ut-robotics/picr21-team-bts/README.md

# picr21-team-bts
###### 
## Repo Structure Overview:
- > Mechanics [Fusion 360](https://a360.co/3qvp5Xd)
- > Electronics [ELE Dev](https://github.com/ut-robotics/picr21-team-bts/tree/main/Electronics)
- > Final Programming files: [BTS Dev](https://github.com/ut-robotics/picr21-team-bts/tree/main/BTS%20dev)
- > Readme TBA

### picr21-team-bts
To this day nobody knows what B T S<sup>TM</sup> is or what means... 
<sub>but maybe it means: break the solution? who knows!</sub>
##### All we do is: Let's maek tha robit do The Thing!<sup>TM</sup>
