ut-robotics/picr21-team-bts/(threads)

Thread 1 (2021-09-19):

[Mechanics] - Test thrower sketch is not fully defined

Akustav, 2021-09-19:
The sketch is missing some constraints and dimensions, that is why it is blue.
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
If I were to move a vertex, unexpected things can happen, making it extremely difficult to modify this sketch further. Case and point: When moving one corner vertex this happened.
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

mbz4, 2021-09-19:
ok, will add some dimension pointers to the sketch to reference about origin

mbz4, 2021-09-23:
made a hot mess of things but it works now: sketch fully defined (i hope, tested a lot)

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

mbz4, 2021-09-23:
nevermind, just saw the blue peg hole xD
ok fixed!

Akustav, 2021-09-25:
Seems to be OK now with the components, yes.

Closed 2021-09-25.

Thread 2 (2021-09-19):

[Mechanics] - Hole sizes should be correct to their purpose

Akustav, 2021-09-19:
Hole sizes in components are wrong. Holes that need to be threaded should have proper predrill diameters. They can be seen in this PDF

https://www.alliedmachine.com/AlliedMachine/media/AlliedMasterPageImages/Documents/Predrill-Diameter-Chart.pdf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

If you want to have these holes threaded they are too large, if you want to pass a bolt through them, they are to small:
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

Similar issues here:
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

I suggest checking over all the holes in the components.

mbz4, 2021-09-19:
The hole sizes are actually correct.
1) the vertical holes are based exactly as the holes in the adapter plates of the previous teams design and as such i have no say on how they are setup
2) the horizontal holes that i added are not as constrained but the idea of printing the item is that you dont need to pretap in printing, you can tap the threads in later. I will reduce the 2.9mm diameter to 2.5mm
3) the reduced diameter will allow for more 'meat' in the screws to be inserted after the printing is complete, in other words, i will manually add the threads by inserting the screws
4) if you prefer a more reliable attachment method, i could also use a nut, washer, bolt inlay technique or a jig saw resetter type interlock but this would increase the complexity of the preliminary design stage unnecessarily imho

Akustav, 2021-09-19:
1. For the vertical holes, the size is an issue. Tapped holes should be 2.5mm in diameter. Their location itself is OK if the frame has them there (missing from assembly).
2. I am not sure where you got the ideal hole sizes but usually, 3D-printed holes come out a little smaller than expected, requiring re-drilling for any precision at all. If the ramp holes are 2.9mm then the sidewall holes can not be 2.9 mm because a bolt needs to go through them, requiring a larger hole.
3. For component longevity it is suggested to cut proper threads. Threads "cut" using a screw are of lower quality since cutting is not clean and remains stay in the hole. It is OK if you fasten it only once ever but for a re-assemblable component, it should be properly cut. If you need more meat it can be adjusted in the slicer.
4. Bolts and threads are sufficient, it is just very unclear where holes need to be threaded and where not. This ambiguity is not good.

mbz4, 2021-09-23:
>> side adapter with motor mount hole sizes fixed: 3.1mm in passthru adapters, 2.5mm in chassis mounts
>> side adapter with no motor mount hole sizes fixed: same as above
>> ramp: tapped hole dim now corrected to 2.5mm

Akustav, 2021-09-25:
Seems fine now, yeah. Closing issue.

Closed 2021-09-25.

Thread 3 (2021-09-19):

[Mechanics] - Thrower arch is weird

Akustav, 2021-09-19:
I am not sure why the throwers ramp is designed in such a way:
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
The radius is not aligned with the centre of the motor. The ball does not seem to make a lot of contact with the ramp at the beginning of the throw.

Additionally, the ball makes contactwith the motor alot sooner than with the ramp. This can force the robot to jump, reducing accuracy. This happens when the ball is pulled from position one to position 2:
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

mbz4, 2021-09-19:
Again, the measurements for motor position are only referenced from last years robot model.
In the given timeframe it was not possible to finetune the design to this degree.
Additionally, the ramp geometry is comprised out of two concentric circles, the motor axis is indeed not in the central axis mount as it should be. The draft angle between both ramp curves serves as the simplest self-centering geometry I could quickly implement.
One solution may be that I move the motor mount up a few mm such that the 'jump' would not occur, assuming the carpet is as depicted.

Akustav, 2021-09-19:
I think you should align the centre of the motor with the ramps curvature centre. Since you have full control of where the motor is located then you can also decide how far the ramp extends, helping avoid the issue where the robot is lifted during ball acquisition.

Using pro-paint skills I have illustrated some changed that would be nice:
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

Akustav, 2021-09-27:
Hey! Still a little bug here:
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

Akustav, 2021-10-03:
Closing due to new design

Closed 2021-10-03.

Thread 4 (2021-09-19):

[Mechanics] - 3D print orientation

Akustav, 2021-09-19:
In what orientation do you plan to 3D-print the central part? You need to take into consideration that one can not print on air. I am not sure if you considered it. It is not immediately clear to me.

mbz4, 2021-09-19:
1) https://www.explainthatstuff.com/how-3d-printers-work.html ...this is the thrower design review request, not print setup... for that i would first need slicer profile settings and slicing to take place...
2) the part is already designed in print orientation - the bottom most face allows for sufficient adhesive area such that the layers atop will not detach the piece off a properly calibrated buildplate
3) the part has no angles exceeding 60degrees in layering (see prusa references on design recommendations)

Akustav, 2021-09-19:
Ok. I guess this works. Just an additional thing that layer orientation in 3D printing matters, similar to how it is on wood. For this component the presented orientation most likely will work, just was not clear from the onset.

Closed 2021-09-19.

Thread 5 (2021-09-19):

[Mechanics] - Thrower missing chassis assembly

Akustav, 2021-09-19:
The thrower assembly does not include chassis components, making it hard to judge the distances between the motor and the ground of the machine. Additionally it is hard to judge if it is attachable to the existing test-chassis.

mbz4, 2021-09-19:
Instructions did not mention the assembly needs to include chassis parts even though I referenced all dimensions from model and real parts.
These seem like superficial issues but I will add them to the model.
The bottom most face of the ramp component is exactly on level with last years ramp bottom.

Akustav, 2021-09-19:
Having the chassis in the model helps to see that. Since these components do not work in a vacuum but need to operate in an assembly it is important to see that everything fits together and operates as expected.

Closed 2021-09-27.

Thread 6 (2021-09-19):

[Mechanics] - Intererence between components

Akustav, 2021-09-19:
There are components that sit inside one another. They can be seen below:
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

mbz4, 2021-09-19:
not sure i understand, but perhaps the joinery was not up to the task
i can offset the joints in the assembly if thats the issue

the adapter rings are there because i noticed and measured an offset of about 2mm either side
Im not sure what else would cause the interference but this is what you can expect in rushed designs.

Akustav, 2021-09-19:
The spacers seem to be placed wrong, they are 2 mm wide for a 1.7mm gap.

Akustav, 2021-10-03:
Clsoing to review new iteration

Closed 2021-10-03.

Thread 10 (2021-10-03):

[Mechanics] - add chamfers to simplify assembly

Akustav, 2021-10-03:
Adding chamfers to tabs should simplify assembly and it should not affect manufacturing times.

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

mbz4, 2021-10-03:
Will add chamfers on key insert edges.

mbz4, 2021-10-03:
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
Done on all contacting insert edges.

Thread 11 (2021-10-03):

[Mechanics] - add chassis components to assembly

Akustav, 2021-10-03:
Currently the assembly has only the thrower. Add the important chassis components there to validate that there is no interference between components and that the attached throwers parameters match with clearance and other factors.

mbz4, 2021-10-03:
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

mbz4, 2021-10-03:
Chassis added to assembly. Attached thrower assembly's parameters match with clearances and other factors.

mbz4, 2021-10-03:
See to assembly file: "BTS TEST ROBOT ASSY.v3"

mbz4, 2021-10-03:
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

Thread 7 (2021-10-03):

[Mechanics] - use chamfer instead of bevel

Akustav, 2021-10-03:
I suggest using chamfer here so certain parts are not printed on thin air:

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

This change should not break anything on first check.

mbz4, 2021-10-03:
Agreed, fillet angle exceeding 60degrees. Disregardable if using layer height under 0.15mm but will apply chamfer regardless.

mbz4, 2021-10-03:
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
Done.

Thread 8 (2021-10-03):

[Mechanics] - sidewall consist of 2 bodies

Akustav, 2021-10-03:
The sidewall consists of 2 bodies. I think you want to unify them into one, since it is one component. To do that you can use the "combine" modifier.

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

mbz4, 2021-10-03:
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
Fixed: sidewall now a single body. Moved extrude over by one slot then used Join method in adapter block extrude.

Thread 12 (2021-10-08):

[Mechanics] - deepen holes

Akustav, 2021-10-08:
I suggest making these holes deeper. Threading tools have a tip that can not be used for cutting and a deeper hole makes for better threads and for more space for shavings to go.

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

mbz4, 2021-10-08:
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
Done. Reslicing now.

Closed 2021-10-29.

Thread 17 (2021-10-25):

Code functionality hard to extend

Akustav, 2021-10-25:
https://github.com/ut-robotics/picr21-team-bts/blob/150fad70ade07c8de07883c7dcfbdee1cfe69f68/Mainboard%20Communication%20Tasks/basic.py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

The current program is written as a monolith and not expandable. All tasks during the course build on top of the previous tasks. I would therefore suggest a state machine and the first state can be for simple motion forward.

Farnaz03, 2021-11-08:
Working on it: https://github.com/ut-robotics/picr21-team-bts/tree/main/Programming

Akustav, 2021-11-12:
Added another issue explaining basic state-machine stuff. Closing this one

Closed 2021-11-12.

Thread 19 (2021-10-25):

Reduce duplicate code

Akustav, 2021-10-25:
https://github.com/ut-robotics/picr21-team-bts/blob/150fad70ade07c8de07883c7dcfbdee1cfe69f68/Mainboard%20Communication%20Tasks/main2_1.py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

Currently motor speed calculations, sending and camera logic is duplicated in multiple files. I would suggest moving common logic to separate files.

Farnaz03, 2021-11-08:
Working on separating it: https://github.com/ut-robotics/picr21-team-bts/tree/main/Programming

Closed 2021-11-08.

Thread 21 (2021-10-25):

Abstraction layer for motion missing

Akustav, 2021-10-25:
https://github.com/ut-robotics/picr21-team-bts/blob/150fad70ade07c8de07883c7dcfbdee1cfe69f68/Mainboard%20Communication%20Tasks/main2_1.py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

The current  motion code sends raw motor speeds to the mainboard. This is a non-intuitive way of moving omnidirectionally and in all likelyhood in need of an abstraction layer.

Farnaz03, 2021-11-08:
Kindly review: https://github.com/ut-robotics/picr21-team-bts/blob/main/Programming/maneuver_inator.py
Let us know if this works better. We took inspiration from LoganPaul (2020), Thomas The Dunk Engine (2020), Team Kobe (2021), Team Jordan (2021) and also your suggested side, forward, rotate movement structure - but we have so far only implemented a single move command.

Akustav, 2021-11-12:
Seems more reasonable now.

Closed 2021-11-12.

Thread 22 (2021-10-29):

[Mechanics] - roller number does not divide by fastening holes

Akustav, 2021-10-29:
Currently you have 25 rollers for 4 fastening holes. I would suggest either going with 40 rollers or 5 fastening holes.

mbz4, 2021-10-29:
Since we are limited to 20 rollers per wheel, it is not possible to go with the 40 rollers option.
5 fastening holes is a better solution. Guess I will make this solution work then.

mbz4, 2021-10-30:
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
Done.

Akustav, 2021-10-31:
OK

Closed 2021-10-31.

Thread 23 (2021-10-29):

[Mechanics] - motor fastener impossible to lathe

Akustav, 2021-10-29:
All torque related to robot movement will be transferred through the fastening piece. The load is also dynamic since accelerations are quire strong on these pieces. I suggest making it out of metal (aluminum or similar) using the lathe.

mbz4, 2021-10-29:
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
Hey, the adapter piece is made of aluminum: I figured I could use the lathe to get the rough diameter then the mill to mill out the retention hole. Another solution is to simply use the lathe and make a monolith cylinder, with a side where the screw goes through to pin on the shaft of the motor, holes for the wheel screws and of course the hole for the motor shaft - not sure how to make the flat edge in that case but it should work even without it.
In the design, I actually use a flat face on the printed base and lid blocks to help translate the torques but these parts are not meant to work alone in this fashion. I wanted to distribute these loads as much as possible.

I guess I should remake the design to whatever we can fabricate then.
There should be something I can do to simplify this design.

mbz4, 2021-10-30:
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
Perhaps an adapter like this would be better then: 2 separate radii to lathe out, a centre bore for the motor shaft. Then on the mill: 5 vertical screw mount holes  (2.9mm dia), 1 cross-cut horizontal screw hole.

I went with a through cut on the horizontal screw mount in case we want to use part of a threadlocked screw insert as the flat face against which the motor shaft rests and/or as a second retention screw.
In any case it is an optional part that is simply a nice through-mill to fabricate.

mbz4, 2021-10-30:
I would sand the edges to get the chamfers except for the inner most one which can be achieved if I simply avoid lathing that part to get a nicer transition to the central shaft holder.

mbz4, 2021-10-30:
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

Akustav, 2021-10-31:
I would use the second variant, yes. One thing I think we can change is to reduce the OD of the holder. This lets us save material and reduce the time of making this piece. The 4/5/however many fastening holes can be pretty close to the edges of the shaft holder and the OD.

One suggestion I can make is that the holes holding the motor shaft should be offset from the wheel fastening holes, like so:

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

This reduces possible assembly complications in the case some the bolts used are too long

mbz4, 2021-10-31:
Seems the thread here is out of date: I addressed this issue soon after posting the above screenshots. It's angled correctly now, but to achieve this, I had to reposition the fastener holes in order to keep the horizontal retentors aligned with the flat of the motor shaft.

mbz4, 2021-11-02:
Why is this issue still open?

Akustav, 2021-11-02:
Current design is better.

Closed 2021-11-02.

Thread 24 (2021-10-29):

[Mechanics] - donät leave play on the motor shaft hole

Akustav, 2021-10-29:
Currently the radius of the motor shaft hole is 3.1 mm. I suggest not leaving any play there.

mbz4, 2021-10-29:
So you suggest the roller shafts should be immobilized and inside a contour that maximizes friction.

mbz4, 2021-10-30:
Done: motor shaft hole = 3mm

Akustav, 2021-10-31:
In what model was this changed?

mbz4, 2021-10-31:
Both the twin-bore and regular.

mbz4, 2021-11-02:
Why is this issue open still?

Akustav, 2021-11-02:
Is OK now

Closed 2021-11-02.

Thread 25 (2021-10-29):

[Mechanics] - Change way how rollers are retained

Akustav, 2021-10-29:
Currently the tolerances for the rollers might be to little and they might not spin freely. To avoid this you can increase side clearance on either side to around 0.2-0.3 mm and extrude a cone like area around the roller shaft that supports the roller from movement. The tolerances on the cone can be right at 4.0mm.

Visual illustrations (not to scale):

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

An example wheel picture

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

mbz4, 2021-10-29:
I can approach this issue by making the hole model for the rollers separate of the hole model for the shafts. I'll therefore define a new sketch on the side of one roller wall and then make a cut and then use the circular pattern on this cut for all the rollers.

mbz4, 2021-10-30:
Somehow missed the point about the extruded conical shape to keep the roller tight at 4.0mm while permitting play at 0.2-0.3mm in all new designs...
I think I can add it still but this will involve several hundred modifications.
Do you need me to fully assemble the wheels for each iteration or can I leave the non-final versions more disassembled (only 1 or 2 rollers fitted for illustration).
Can fully assemble once we've gone thru feedback I guess.

mbz4, 2021-10-30:
Okay, fixed for standard config. Tackling twin-bore config next.

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

mbz4, 2021-10-30:
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
It's just a conical extrusion, achieved thru a standard solid join extrude, then chamfered to a nice tip.

mbz4, 2021-10-30:
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
Done for both wheel configs.
Reviewed all issues again and I think it's all addressed adequately now.
Kindly accept the final design for submission per pending task requirements.

Akustav, 2021-10-31:
Seems nice now.

Closed 2021-10-31.

Thread 26 (2021-10-29):

[Mechanics] - plans on covering the wheel

Akustav, 2021-10-29:
A question regarding how the wheel will fit into the whole assembly. Do you plan to cover the wheel?

This is important because currently rollers and bolts holding the wheel together can damage parts of the field (baskets) and opponents when they are grazed by the spinning wheel.

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

mbz4, 2021-10-29:
I thought we could inset the entire wheel-motor assembly inside the robot chassis such that this would not be an issue. With regard to this, I would prefer to just have the chassis encircle the entire assembly. If this is a new addition to the competition guidelines, I can make the screws sink into the wheel itself with counterbores and make the blocks thicker as well.

Akustav, 2021-10-31:
Having wheels in the chassis is reasonable. Just pointed out this to be careful with.

Closed 2021-10-31.

Thread 27 (2021-10-30):

[Mechanics] New repatterned roller design based off feedback.

mbz4, 2021-10-30:
Didn't have a chance yet to repattern the twin bore config but this is a learning process so have patience.

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

Here's the newly repatterned wheel: diam is now 7cm, 20 rollers, 4 fasteners, lathable adapter, wheels intended for use inside the chassis. If this not acceptable, can extend base and lid blocks to encompass roller diam and have screw points in-bore.

mbz4, 2021-10-30:
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
I'll start work on a rough outline of the motor mount next.
Having an easily modifiable motor mount design series would help me with quick sanity checks in the wheel design department.

Also, I used the feature circ. pattern on a 8mm cut for all the roller shafts such that the resulting contour is tight fitting with no play. The roller bearing play is now 0.275mm either side of the roller. This is within the margins you specified. Even if 3dprinted, the shafts might be too constricted and the resulting assembly could deform due to printer tolerance mismatches.

mbz4, 2021-10-30:
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
Adjusted fastener holes to allow the horizontal fasteners enough space.
Aligned horizontal fastener with flat part of motor shaft.
Working on counterbores next.

mbz4, 2021-10-30:
Wanted to wrap up this assy before moving on to the twin-bore or the motor mount design daft.
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
Counterbores added: don't mind having them on either side of the wheel block because I thickened the wheel so that it now encompasses the entire roller diameter. This way there is 4mm of material from the bore to bore fastener hole to keep the parts clamped together. This shouldn't be an issue.
Will consider now this wheel assy done.

mbz4, 2021-10-30:
The counterbore mismatch was irritating so  I decided to have 2 distinct blocks instead such that the lid simply does not feature the counterbore for the fasteners.

mbz4, 2021-10-30:
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
Here's the twin-bore concept with 20 roller wheel assy, 10 rollers per base. Roller shafts fit in the contoured shapes nicely. The fasteners are a divisible of 20, but could have used 4 instead of 5 as well - 10 roller per wheel, 10 not divisible by 4 (thought process). The fasteners need to be about 30mm long, can cut to size if necessary. The rollers are fit inside the base blocks of the wheels. The entire motor mount assembly is at this moment assumed to fit the whole motor with wheel and mount inside the chassis perimeter.

Akustav, 2021-10-31:
I tried a quick prototype of a central unibody design:

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

Its diameter is 20mm and thickness of components is 4mm for the caps and 13mm for the center.

The center piece:
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

Akustav, 2021-10-31:
But the layered approach itself is a little simpler to manufacture. I guess

mbz4, 2021-10-31:
I thought ~30mm is the minimum radius possible unless you use a second gearbox.
Why this limit?
PC plate = 4.8mm
...need about 5mm off the bottom...
Need 'some' clearance for motor mount...
... motor shaft is offset additionally...
...putting the total at about 15mm radius minimum, resulting in 30mm diameter limiter.
I would add another margin there for fasteners and ease of installation.

Seeing how the top/bottom layouts intertwine, I think this could actually print just fine, just set the params for fine detail and ensure z res is sub 0.1mm
Bridging in your solution is not a problem either.
This would therefore work just fine but again, the diameter here might be too small unless an extra gearbox is added.
I would prefer to avoid the extra failure point and just make the wheel diameter at 30mm+ or how I set it at 'ball' diameter.
Do you want me to prepare a unibody config as well?

Akustav, 2021-11-03:
I am not sure what limitation you point at. I would make the wheel as small as needed to fit a set amount of rollers. Therefore the number of rollers decides the diameter, basically. As for printing, I am sure it is possible, just can be more fiddly since you are printing one roller slots upside-down with  the unibody.

As for height. The PC is 4,8mm but the motor can be recessed into the chassis. Similar to this:
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

Closed 2021-11-02.

Thread 31 (2021-11-02):

Weird handling of motor speeds in the motion module

Akustav, 2021-11-02:
Currently the motionModule creates a request object on construction that is used to keep motor speed data. Would it not be more reasonable to send a Request to the MotionController that then parses this request data and sends the speeds, returning motor feedback as a Response?

I see you have a setSpeed function that sets the Request object parameters but why not give the Request object to the Controller directly?

https://github.com/ut-robotics/picr21-team-bts/blob/f72089bd664bcdcd6df3d51b7ef4cdaa65b46ecc/Mainboard%20Communication%20Tasks/motionModule.py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

https://github.com/ut-robotics/picr21-team-bts/blob/f72089bd664bcdcd6df3d51b7ef4cdaa65b46ecc/Mainboard%20Communication%20Tasks/motionModule.py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

Silaris, 2021-11-02:
You mean change self.req = Request()  to self.req = { a =1, b=2, c=3) in constructor?
Can do so. Creating additional classes, types, or interfaces for data models is my habit from TS and C#.
setSpeed function existence does not prove it will be used always. It is an option to set speeds as an array, not one particular value.

Akustav, 2021-11-02:
I would suggest using the Request instant for the motor_speed_val_input method, so it can be used something like this:

Request req = Request(speeds...)
motModule.mototor_speed_val_input(req)
#now the motor speeds are set. Technically it could also send the speeds right away, depends on what you want.

Closed 2022-01-21.

Thread 32 (2021-11-02):

Uneven casing in python code

Akustav, 2021-11-02:
As was the case with C code so should python code be unified under one standard. Currently you have multiple syntaxes mixed.

https://github.com/ut-robotics/picr21-team-bts/blob/f72089bd664bcdcd6df3d51b7ef4cdaa65b46ecc/Mainboard%20Communication%20Tasks/motionModule.py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

https://github.com/ut-robotics/picr21-team-bts/blob/f72089bd664bcdcd6df3d51b7ef4cdaa65b46ecc/Mainboard%20Communication%20Tasks/motionModule.py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

mbz4, 2021-11-02:
What's the problem with that?

Akustav, 2021-11-02:
You use camelCase and snake_case at the same time. You should decide on one and use it.

Silaris, 2021-11-02:
Got you. It was 2 programmer code combination and we are using different styles D Will change

Closed 2021-11-12.

Thread 33 (2021-11-02):

Motor speeds should be defined programatically

Akustav, 2021-11-02:
The current way how motor speeds are defined is weird is as in the user needs to provide input before it starts. This is pretty useless as code evolves. It would be more reasonable to define a set speed/direction inside code and drive based on that.

https://github.com/ut-robotics/picr21-team-bts/blob/f72089bd664bcdcd6df3d51b7ef4cdaa65b46ecc/Mainboard%20Communication%20Tasks/base.py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

mbz4, 2021-11-02:
It is useless to whoever tries to use it apart from the guy ACTUALLY building the bot who just needs to access those few variables. Again, how did this get here in main commit?

Akustav, 2021-11-02:
I am not sure how this code got here but it is very narrow in scope and is unusable further in the project, therefore of low quality.

Silaris, 2021-11-02:
base3.py (current version) does not include this input. It is just for playing.

Akustav, 2021-11-02:
There are currently quite a few baseX.py files. Maybe it is reasonable to clean this up to have one base?

Silaris, 2021-11-02:
Will clean them up with a new camera controller. Now it is stored in base2.py with cv only and base3.py with realsense (faster to program in 1 file for test purposes)

Akustav, 2021-11-02:
Okay. I would use either folders to designate test code or keep them in a separate branch, else it can be difficult to understand what generically named files like base1, base2 and similar are supposed to do

Closed 2022-01-21.

Thread 35 (2021-11-02):

[Mechanics] - change way roller shafts are retained

Akustav, 2021-11-02:
I would suggest changing the way how rollers sit inside the wheel housing. Currently you have 2 semicircles that enclose the shaft but you can encounter alignment issues due to the more complex matching between 2 moving semi-circles.

I would suggest a slot that is as deep as the shafts diameter and a flat surface retains this shaft in the housing.

A picture to illustrate:
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

mbz4, 2021-11-03:
Thank you for the suggestion, I will implement it because there are too many misalignment opportunities that could cause this. It may be possible to have a shape on the locking block to enclose them fully but that might again be asking for trouble.

mbz4, 2021-11-03:
I'll make a new design for the twin-bore that has a unibody mid section like your proposed solution.

Akustav, 2021-11-03:
Let me know when ready

mbz4, 2021-11-03:
Done!

Akustav, 2021-11-06:
OK

Closed 2021-11-06.

Thread 36 (2021-11-02):

[Mechanics] - countersink style

Akustav, 2021-11-02:
Was wondering you you plan to use this style of countersink head or want to use, for example, a conical head?
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

mbz4, 2021-11-03:
We discussed this issue previously and in person: it would need 5 torx conical screws, ~30mm each. None are in stock at this length so for the twin-bore it is out of the question. We could apply them however to the regular wheel instead.

Akustav, 2021-11-03:
I think we can get the screws. Do I understand correctly that you want to use the twin-design?

mbz4, 2021-11-03:
We discussed that it would not be a problem if we keep both. But yeah, for now the ideal focus is to use the twin-bore (unibody) design.
The standard wheel design serves as backup in case the configuration misbehaves or something about movement dynamics...

mbz4, 2021-11-03:
If you are getting the torx screws, let me know their exact dimensions so I can model them in to test the fittings. I don't believe we have a problem in using either design, despite the 'ugly' counterbores.

Akustav, 2021-11-06:
https://www.tme.eu/en/details/b3x25_bn20039/bolts/bossard/3183910/ This would be a screw

Akustav, 2021-11-06:
I will close this task for now, I think the overall point was made.

Closed 2021-11-06.

Thread 37 (2021-11-02):

[Mechanics] - drill through fastener if possible to simplify threading

Akustav, 2021-11-02:
I suggest threading through the wheel shaft mount to simplify threading:
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
Seems like one hole is harder to do since it collides with the crossing hole. Does it need a full-length hole?

mbz4, 2021-11-03:
From memory, I think they only need 2-3 mm, ~1mm short of the horizontal shaft fastener. We also discussed dropping down to 4 fasteners in this adapter case. That would resolve the collision issues as well as slightly reduce weight and complexity.
I want to use this adapter for the regular wheel configuration as well, despite the short displacement of fasteners from motor shaft.

mbz4, 2021-11-03:
Done!

Akustav, 2021-11-06:
OK

Closed 2021-11-06.

Thread 39 (2021-11-06):

[Mechanics] - wheel bearing support lips may be too long

Akustav, 2021-11-06:
The extended lips can be shortened to stop potential interference with the bearing. The bearing has some play in it and when extending this lip more than the center it can make contact with the rolling part.

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

mbz4, 2021-11-12:
Fixed on unibody twin-bore.

Closed 2021-11-12.

Thread 45 (2021-11-12):

Have a state machine here

Akustav, 2021-11-12:
This issue explains how the basic state machine can look like.

You should define an enum class, that contains all possible states the robot can have. This class can look something like this:
```
from enum import Enum
class State(Enum):
 IDLE = 0
 FIND = 1
 DRIVE = 2
 AIM = 3
 THROW =4
 MANUAL = 5
```

You will then have a variable `state `that contains a `State` instance. Example for initialization:
`state = State.IDLE`

Inside your while loop, you want to have a state machine that handles these different states. Idle obviously just stands there, Find finds a ball, Drive drives to it, and so on. It can look something like this:

```
while True:
 if state == State.IDLE:
  ...just stand there...
 if state == State.FIND:
   ...rotate and find a ball inside the frame...
   ...if ball in frame, state = State.DRIVE...
 if state == State.DIVE:
   ...drive to ball as required...
   ...if ball is close enough, state = State.AIM...
 ...

```

Such a construction also allows you to separate logic more strictly and it is easy to add new states and scenarios to the existing structure without the need for refactoring.

https://github.com/ut-robotics/picr21-team-bts/blob/7265ff898f0d363548db53aa734a4fa25327b038/robit_manager_inator.py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

Silaris, 2022-01-19:
Find state improved. (Image processing moved to a parallel thread)

Closed 2022-01-21.

Thread 47 (2021-12-18):

Move ESD protection as close as possible to connector

ReikoR, 2021-12-18:
Having ESD protection close to the connector helps to prevent ESD spikes from propagating to other components.

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

Closed 2021-12-23.

Thread 48 (2021-12-18):

Use wider tracks for power

ReikoR, 2021-12-18:
Wider and shorter tracks should be used to reduce resistance and inductance.

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

Closed 2021-12-23.

Thread 49 (2021-12-18):

Move 3.3V voltage regulator closer to USB 5V

ReikoR, 2021-12-18:
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

Shorter track has lower inductance.

Closed 2021-12-23.

Thread 51 (2021-12-18):

Don't connect mounting holes to power nets

ReikoR, 2021-12-18:
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

I would recommend not connecting mounting holes to any nets. Just to decrease the chance for accidental shorts.

Closed 2021-12-23.

Thread 54 (2021-12-18):

Avoid overlapping schematics objects

ReikoR, 2021-12-18:
Some problems:

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

Closed 2021-12-24.

Thread 55 (2021-12-18):

Add board outline to Mechanical 1 (M1) layer

ReikoR, 2021-12-18:
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

Board outline should be on Mechanical 1 layer. You need to modify the component libraries and put 3D bodies that are on M1 layer to M13 layer.

ReikoR, 2021-12-24:
There is something on the Micro-Match footprint that is on the M1 layer:

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

Corners of the board outline are misaligned and not proper 90 degree angles:

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

You can use coarser grid to make it easier to place the lines.

Better option is to use **Design -> Board Shape -> Create Primitives from Board Shape**.

More info:
https://www.altium.com/documentation/altium-designer/pcb-obj-boardshapeboard-shape-ad

Closed 2021-12-26.

Thread 56 (2021-12-18):

Micromatch connectors are too close to each other

ReikoR, 2021-12-18:
Plugs are wider than the sockets on the board.

From [Micromatch catalog](https://www.te.com/commerce/DocumentDelivery/DDEController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) pages:

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

On the PCB:
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

Closed 2021-12-23.

Thread 57 (2021-12-21):

Hardcoded ID value

Akustav, 2021-12-21:
Current code has a hardcoded ID value in multiple places. The competition might not use your robots hardcoded ID for it. Changing it can be error prone. I suggest either having it as a separate input variable or define it in the top of the module and reference that constant.

https://github.com/ut-robotics/picr21-team-bts/blob/c1d9243da79889edd1263d32d90fceefeffa7f66/BTS%20dev/ws_client.py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

Silaris, 2022-01-19:
Moved to cycle. Bts is now a parameter in the shared data. (most likely will need to move it to the config file but it is not important now)

Closed 2022-01-21.

Thread 61 (2022-01-12):

Robot is at an angle in the assembly

maidlam, 2022-01-12:
Better for future work if the robot plates were parallel with the floor.
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

mbz4, 2022-01-12:
fixed!
used inspect tool and checked offset from origin top plane to get difference to zero for bottom chassis part

Closed 2022-01-13.

Thread 62 (2022-01-12):

Motor mounting rails might be unnecessary

maidlam, 2022-01-12:
The rails make assembling the robot more difficult, e.g. when mounting the top plate, it adds more things that have to be aligned for the top plate to mount.
The rails, combined with the recessed bolt holes, make it so that the plate has to be milled from both sides.

Better to avoid using the rails.

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

Closed 2022-01-16.

Thread 63 (2022-01-12):

Camera mount - recessed bolt holes

maidlam, 2022-01-12:
I think it might be structurally better to not have these holes recessed.
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

mbz4, 2022-01-12:
fixed!
made new gantry mounts for the camera adapter with adequate space for the camera itself

Closed 2022-01-16.

Thread 64 (2022-01-12):

Camera mount - RGB camera position not in center

maidlam, 2022-01-12:
The RGB sensor of the D435 is located on the opposite side of the USB port.
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

Use the "Intel RealSense Depth Camera D435" from here: https://dev.intelrealsense.com/docs/cad-files
There download should give a STEP file, that can be uploaded to your project in Fusion360.
The model has the position for the RGB camera.

To get the RGB camera to the center of the robot, depending on the design, you might have to have the camera extend outside of the camera mount, and might need to make a cut-out for it.

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

mbz4, 2022-01-12:
done:
got new model
uploaded model
aligned model
repositioned mounting holes to match
camera aligned to centre of bot

Closed 2022-01-13.

Thread 65 (2022-01-12):

Camera mount - FOV pyramid issues

maidlam, 2022-01-12:
The pyramid isn't angled perpendicular to the camera, angles are 70 degrees and 67,5 degrees.
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

I think the pyramid shape is wrong at the bottom.
Actual view might see more of the wheels.
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

mbz4, 2022-01-12:
done!
was tricky but in the end I used an elliptical cone shape to achieve the FOV overview
I moved the camera higher and a bit further back with the new gantry design.

Thread 66 (2022-01-12):

Front motor mounts missing bolt holes in bottom plate

maidlam, 2022-01-12:
The front two motor mounts are missing holes for the bolt in the bottom plate.
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

Closed 2022-01-13.

Thread 68 (2022-01-12):

Threads don't have to be modelled

maidlam, 2022-01-12:
Might be better for general modelling performance to not have the threads modelled.
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

mbz4, 2022-01-12:
fixed on camera gantry but not on motor mounts yet

maidlam, 2022-01-13:
What I meant was that the threads in holes shouldn't be a 3D model, but when making a threaded hole, Fusion360 can show a texture instead.
There's an option in the "Hole" and "Thread" features to have the thread modeled. When there's no tick in the box, a texture will be shown instead.

The whole assembly should still show, which holes are threaded.

Picture is of the "Thread" feature in a motor mount side wall.
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

Closed 2022-01-16.

Thread 69 (2022-01-16):

NUC back bolt hole missing in top plate

maidlam, 2022-01-16:
The back hole for mounting the NUC is missing from the top plate.
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

mbz4, 2022-01-16:
Fixed.

Closed 2022-01-16.

Thread 70 (2022-01-16):

Check clearance of mainboard

maidlam, 2022-01-16:
I think there were some big capacitors on the mainboard.
Check the height of those capacitors to see that the mainboard fits behind the back motor.
Current distance between mainboard and motor is 12,2mm.
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

mbz4, 2022-01-16:
Steve assured me no Electrolytic caps are used in our mainboard design. Which means this could be a generous clearance margin. the 5mm standoffs are also optional. Just in case, added 3 extra mm of margin. Was trying to save space in case I fit the advanced thrower.

mbz4, 2022-01-25:
Given an entire finger fits after installation, I'd squarely say this issue is resolved. Closing.

Thread 71 (2022-01-16):

Clearance issues with tenons

maidlam, 2022-01-16:
Check over all of the colored parts. Can cause fitting issues.
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

mbz4, 2022-01-16:
The motor mounts have a 0.05mm margin.
The Gantry features no margin - should I add the 0.05 to gantry mounts?

maidlam, 2022-01-16:
1. Motor mounts
The motor mounts holes are different dimensions - the tenons are 17,5mm, while their corresponding holes are 17,475mm wide. That is causing the interference there.
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

2. Gantry
The holes for the gantry don't need a margin, but the holes for the tenons are also out of alignment.
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

mbz4, 2022-01-16:
Motor mounts:
fixed on top chassis, removed clearance margin on bottom chassis (mounts remain fixed more often than on top chassis)
Gantry:
cannot identify where the misalignment occurred
Perhaps its a bad joint?

mbz4, 2022-01-16:
Joint is sound. Still cannot find cause for misalignment nor did I find any misalignment.

mbz4, 2022-01-16:
Fixed gantry assembly misalignment source.
To be sure, I extended the gantry to 118mm internal distance, applied to top and bottom chassis as well (battery cradle mounts had to be offset)

maidlam, 2022-01-16:
Still some issues with the bottom tenons of all the motor holders. The distance between the holes in the bottom plate is slightly bigger than the distance between the tenons.
Also, one of the holes in the top plate is missing.
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

Closed 2022-01-17.

Thread 72 (2022-01-16):

Thrower sidewalls could be milled out

maidlam, 2022-01-16:
Are the thrower sidewalls going to be brand new?
If not, then they could be milled out instead.

The current wall dimensions in the model seem to support that, and since the most of the robot is being milled out, these could also be milled out
The distance disk from the wall to the thrower motor would be printed separately.
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

mbz4, 2022-01-16:
The thrower design is actually not up for review as that task was already reviewed. A new thrower will be developed next week and so I just fit this one with an additional cut to serve as a visual stand-in.  To fit LoganPaul's test thrower we currently use, I will simply saw-off 7.6mm off the front part, sand it and then fit it into the new chassis. The advanced thrower will likely have to be milled and not printed but the design does not yet exist.

Closed 2022-01-16.

Thread 73 (2022-01-16):

Side armor interference

maidlam, 2022-01-16:
1. The side armor is inside the top plate, at both sides in the back.
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

2. Giving the side armor top edges some distance between the top plate could ease assembly. In the case where the side armor is already attached to the robot (but the top plate is detached), the extra distance can help avoid having to align things.
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

Thread 74 (2022-01-17):

Remove tabs to increase ease of assembly

Akustav, 2022-01-17:
For ease of assembly I suggest to remove the tabs on the back plate of the motor boxes. Otherwise a high level of precision is needed to attach the motors to the board and the top plate to the rest of the robot. Area is circled in red.

Additionally, you could technically skip the back- and sidewalls entirely. This reduces your mill, finishing and assembly processes. Your call.

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

mbz4, 2022-01-17:
thought it would help keep the mounts stable and reduce play during motion
also i like the design and spent quite some time on it
i agree on removing the top rear tab tho, it's really not needed
but i want to keep the side walls and back brace models just because :)

mbz4, 2022-01-17:
removed the top tab on the rear brace and the top chassis

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
lamenting the fact the bottom chassis looks kinda like a butt now xD

Closed 2022-01-21.

Thread 78 (2022-01-21):

Utilize existing way of calculating driving speeds

Akustav, 2022-01-21:
I suggest using this method for most speed calculations:
https://github.com/ut-robotics/picr21-team-bts/blob/09e9488ed37ca8907c14233833fe658abc6a5cc7/BTS%20dev/maneuver_inator.py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

It provides a steeper acceleration curve when objects are far away. This provides you with more responsive driving. But you need to keep a few points in mind:
* when the max speeds are too high the robot can overshoot the goal
* maxDeltaSpeed can be alot larger than maxAllowedSpeed, for example 200 and 40
* it takes quite a lot of trial and error to optimize for smooth driving

I am sure this will help you score more faster.

https://github.com/ut-robotics/picr21-team-bts/blob/09e9488ed37ca8907c14233833fe658abc6a5cc7/BTS%20dev/game_logician_inator.py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

Silaris, 2022-01-23:
Do not remember, how this function works. Tried it, the robot was moving not as expected, moved the old function back. The quadratic scale inside it makes it difficult to fit our current linear formulas.

Akustav, 2022-01-23:
If your code is tuned for pure linearity, then nothing can be done at this point.

Below is a chart showing how speeds are calculated with different parameters:
sqrt = calculateRelativeSpeed(i, 100, 0, 300, 0, 50) with `normalizedDeltaFrac = sign * np.power(absoluteDeltaFrac, 2)`
lin = calculateRelativeSpeed(i, 100, 0, 300, 0, 50) with `normalizedDeltaFrac = sign * np.power(absoluteDeltaFrac, 1)`
normal = calculateRelativeSpeed(i, 100, 0, 50, 0, 50)

The difference is profound where max speed is held for more time and breaking occurs later.

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

Thread 79 (2022-01-21):

Duplicate code in aim state

Akustav, 2022-01-21:
The way you determine if a ball is in frame is very redundant. You test both the X and Y values but how can a ball exist only in 1 dimension in a 2D image?

https://github.com/ut-robotics/picr21-team-bts/blob/09e9488ed37ca8907c14233833fe658abc6a5cc7/BTS%20dev/game_logician_inator.py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

Silaris, 2022-01-23:
Removed

ReikoR, 2022-01-23:
https://github.com/ut-robotics/picr21-team-bts/blob/2aaae7a75bbedf2f1caa16b1188a372ebb5a27ca/BTS%20dev/game_logician_inator.py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

It's still not good.

Main point is that, if `self.ballY is None` is true, isn't `self.ballY is None` also true?

Something like this should be enough:
```python
if self.ballX is None:
    self.currentState = State.FIND
    return

curBallX = self.ballX
curBallY = self.ballY
```

Or you can use this if there are bugs in setting `ballX` to `None`:
```python
if self.ballX is None or self.ballY is None:
```

Silaris, 2022-01-23:
Fixed

Closed 2022-01-23.

Thread 82 (2022-01-21):

To different methods to solve the same problem in aim

Akustav, 2022-01-21:
https://github.com/ut-robotics/picr21-team-bts/blob/09e9488ed37ca8907c14233833fe658abc6a5cc7/BTS%20dev/game_logician_inator.py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

Why have the delay here? You are throwing for 40 frames times 0.05 seconds? The cameras framerate is at most 60, so every iteration has at least 16 ms of delay in it. Why not just increase the iteration number?

Silaris, 2022-01-21:
Parallel. We do not wait for the camera frame anymore. But this function will be adjusted letter. We haven't updated the throwing algorithm yet.

Silaris, 2022-01-23:
Updated throw method to additional aiming during the throw. Time. sleep remains. Reduced it to remove the delay.

ReikoR, 2022-01-23:
In general it seems sort of inefficient way to do it. Not sure if there is any benefit right now in running game logic more frequently than camera framerate. For minimum delay it would be better to run everything after new camera frames are received.

Closed 2022-01-23.

Thread 102 (2022-01-25):

No play at all in roller width

Akustav, 2022-01-25:
Currently there is no play between the roller and the sidewalls. This can stall the motor.

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

Akustav, 2022-01-25:
I also suggest adding a spacer to to the front so someone crashing into your roller does not wreck the thrower. It also adds rigidity to the thrower motor.

mbz4, 2022-01-25:
Fixed. Adding spacer.

mbz4, 2022-01-25:
Disregard add spacer - would have to extend adapter plates + the thrower is 3cm further inboard than any robot can reach. It is safe.

Closed 2022-01-25.

Thread 103 (2022-01-25):

Adjustable ramp slot length not aligned

Akustav, 2022-01-25:
Currently the slot lengths are not aligned and the inner slot is shorten than the slot outside:

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

Closed 2022-01-25.

Thread 104 (2022-01-25):

How do you attach the back servo?

Akustav, 2022-01-25:
The holes are very hard to reach and removing the servo will be difficult. Is this intended?

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

mbz4, 2022-01-25:
Yes, intentional and no issue here.

Closed 2022-01-25.

Thread 105 (2022-01-25):

Overall too large reliance on 3D-printing

Akustav, 2022-01-25:
Overall I think there is too much of an reliance on 3D-printing. Most pieces can be manufactured with the router using a much stronger material. This saves time, creates a stronger thrower and produces a more elegant design, overall.

mbz4, 2022-01-25:
no such requirement exists, disregarding as optional

Closed 2022-01-25.

Thread 106 (2022-01-25):

How do you plan to retain the shaft of the roller?

Akustav, 2022-01-25:
Currently due to the direction of rotation, the bolt inside the grab roller will unwind with usage.

mbz4, 2022-01-25:
Addressed.

Closed 2022-01-25.

Thread 107 (2022-01-25):

Motor mount screws interfere with movable ramp arms

Akustav, 2022-01-25:
Bolt heads are taller than 2mm and will interfere here:

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

mbz4, 2022-01-25:
fixed

Closed 2022-01-25.

Thread 109 (2022-01-25):

Warning in thrower assembly

Akustav, 2022-01-25:
Seems some joints have warnings related to them:

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

mbz4, 2022-01-25:
fixed

Closed 2022-01-25.

Thread 110 (2022-01-25):

Thrower motor cable channel?

Akustav, 2022-01-25:
The advanced design does not seem to have a good way for the cables to run into the chassis:

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

Compared to the basic design:

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

Akustav, 2022-01-25:
Space wise it compares as follows:
1.8mm vs 4.2 mm

mbz4, 2022-01-25:
the basic design has 4mm free space irl

mbz4, 2022-01-25:
just in case, added bit more space

Akustav, 2022-01-25:
Seems more reasonable now

Closed 2022-01-25.

Thread 111 (2022-01-25):

Front servo sits inside chassis

Akustav, 2022-01-25:
Currently the front servo is inside the sidewall:

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

mbz4, 2022-01-25:
fixed

Closed 2022-01-25.

Thread 91 (2022-01-25):

Quantity missing from BOM table

ReikoR, 2022-01-25:
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

Closed 2022-01-25.

Thread 93 (2022-01-25):

Internal ramp thickness 5 instead of 4.8

Akustav, 2022-01-25:
The ramp thickness should be 4.8. Currently it is 5.0.

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

Additionally no dogbones:

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

mbz4, 2022-01-25:
No official requirement for material thickness or material choice. Closing with comment.

Closed 2022-01-25.

Thread 94 (2022-01-25):

Spacer question

Akustav, 2022-01-25:
Will all spacers be F-F?

How to you plan to assemble everything here?

If some of them are F-M, then the threaded part most likely does not pass through 5mm, let alone 4.8mm

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

mbz4, 2022-01-25:
Does not matter, can be adjusted in post. Closing.

Closed 2022-01-25.

Thread 95 (2022-01-25):

Weird angle adjustment system

Akustav, 2022-01-25:
. I would suggest having a separate bolt that slides in a similar arm that you have. It can be a little more offset from the ramp arms so it should not create too much interference.

The current solution has a lot of play and does not seem to be too elegant.

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

mbz4, 2022-01-25:
It is a functional design with lots of faults. So is the government. Closing with comment.

Akustav, 2022-01-25:
Re-opened issue due to there being no solution. Movement of the ramp is the core functionality and needs to work, else it might as well not exist.

mbz4, 2022-01-25:
fixed, added 3rd bolt

mbz4, 2022-01-25:
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
bolt length irrelevant, this works as you wanted
assign points - last call

Closed 2022-01-25.

Thread 96 (2022-01-25):

WAY too tight tolerance on movable ramp slot

Akustav, 2022-01-25:
This slot is exactly 3mm in diameter. This is WAY too tight and will most likely jam. There should be at least 1mm of play

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

mbz4, 2022-01-25:
Agreed, adjusting to 5mm.

mbz4, 2022-01-25:
Done.

Closed 2022-01-25.

Thread 97 (2022-01-25):

How do you plan to hold the movable ramp arms in place?

Akustav, 2022-01-25:
Currently the arm is held in place by nothing. What would be used here?

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

mbz4, 2022-01-25:
Done.

Akustav, 2022-01-25:
I think the nut can completely be skipped if you make the 3mm hole a 2.5mm and have a sufficiently long screw. Nothing will bend the arms outwards. If you want to keep the 3mm hole, what nut will you use on the other side?

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

mbz4, 2022-01-25:
self tightening or a 4mm longer screw

mbz4, 2022-01-25:
+ washers

Akustav, 2022-01-25:
Can you use self-tightening nuts? The arm needs to move freely and nuts can not apply pressure to it.

mbz4, 2022-01-25:
the nut is tightened against the arm, not the adapter wall. A washer keeps the clearance.

Akustav, 2022-01-25:
Something like this? Red is where the spacer goes:
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

mbz4, 2022-01-25:
yea, was thinking 2 washers in case

Akustav, 2022-01-25:
But how do you clamp the nut down? Wont it push against the washer and arm, locking them in place?

mbz4, 2022-01-25:
then use a counter nut.

Thread 98 (2022-01-25):

What holds the sensors and LED-s in place?

Akustav, 2022-01-25:
Currently nothing holds these components in place:

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

mbz4, 2022-01-25:
They are held there by sheer will.

mbz4, 2022-01-25:
Added retention feature bracket.

Akustav, 2022-01-25:
Currently the sensors can wobble in the retention clip due to excess space:

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

With LEDs it seems to be less of a problem because legs will be bent through the hole. This brings another issue, wont pins short themselves? Is there space for heatshrink or similar?

mbz4, 2022-01-25:
fixed

mbz4, 2022-01-25:
there is space for heatshrink there in addition to room for bending them each in their own direction

Akustav, 2022-01-25:
Heatshring itself has a wall thickness of around 0.3mm. If you do the minimum and shield 2 wires + some bending, it adds 0.6mm * 2 to the pins. Pins themselves are around 0.45 mm thick. The pin pitch on the sensor is 1.27mm, so in total the width of wires is at least 6.28mm wide and 1mm high. The design has space for 5 mm x 1.5mm

mbz4, 2022-01-25:
that's fine because the phototransistor does not need to stay flush on the face of the wall adapter

Akustav, 2022-01-25:
I think the space issue can simply be resolved by adding some chamfers:

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

Thread 99 (2022-01-25):

30mm bolts most likely too short and not rigid

Akustav, 2022-01-25:
IT seems to me that these bolts are too short and will bend inside soft plastic:

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

I suggest to use spacers.

mbz4, 2022-01-25:
True but I dont think a 40mm M3 bolt even exists ._.

Akustav, 2022-01-25:
Yeah, but there exists 40mm spacers that screw into the holes and don't apply all the force onto the hole. Spacers have a bottom that can rest on top of this component and the friction there transfers forces to the body of the component more evenly

Akustav, 2022-01-25:
Additionally, what fixes the nuts into the plastic? Threads don't bite into the bolt, that is why nuts are also torqued down. Currently the bolts just would not hold the middle ramp in a stable fashion.
