ut-robotics/picr21-team-bts/Electronics/PCB Schematics.pdf

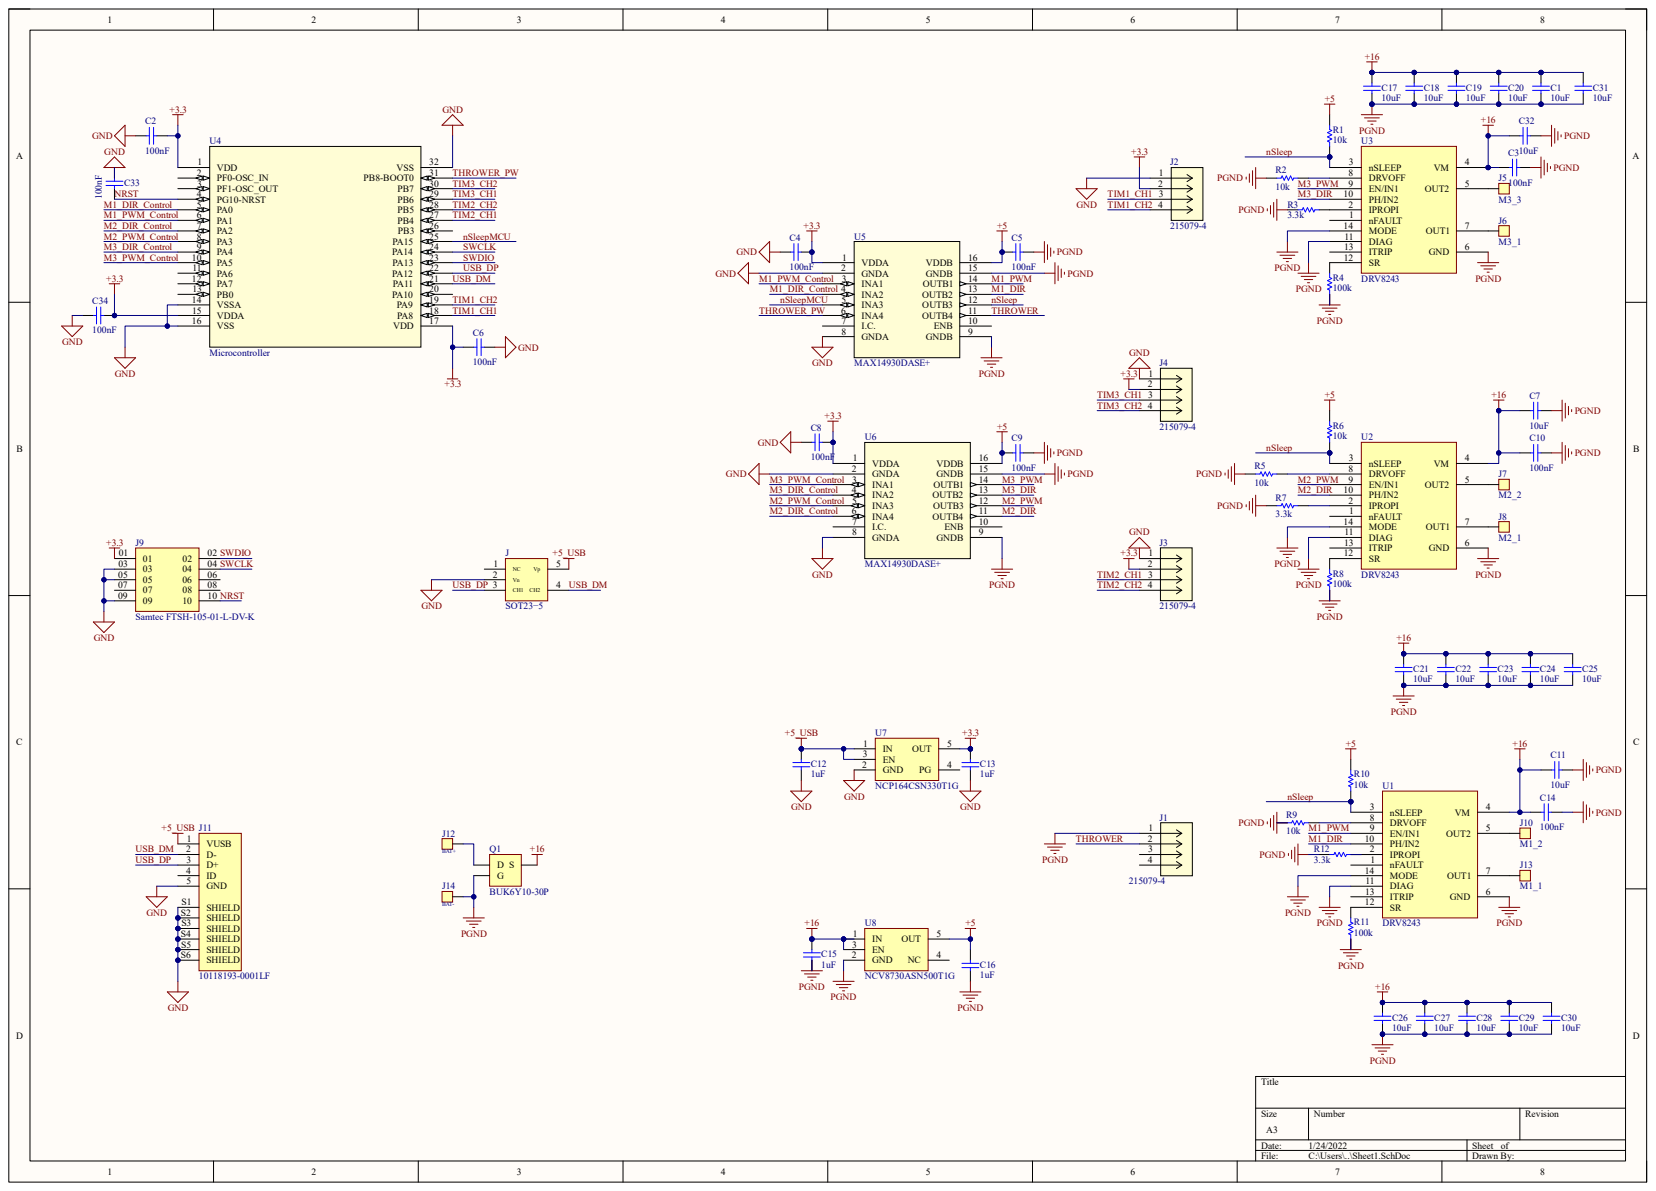
[picture p2: page 1]
