ut-robotics/picr21-team-bts/(list of files, drawings)

Other design files:
Electronics/picr21-team-BTS-mainboard/PCB1.PcbDoc
Electronics/picr21-team-BTS-mainboard/PcbLib1.PcbLib
Electronics/picr21-team-BTS-mainboard/picr21-team-BTS-mainboard.PrjPcb
Electronics/picr21-team-BTS-mainboard/Schlib1.SchLib
Electronics/picr21-team-BTS-mainboard/Sheet1.SchDoc
