ut-robotics/picr21-team-bts/BTS dev/robit_manager_inator.py

#B_T_S Final Code#
#January 26th 2022#

import rc_inator as gui
import threading
import ws_client
import game_logician_inator as game
import maneuver_inator as move

'''
This is the Robot Manager module for the B T S test robot.
'''
print("robit_manager_inator done it's job!\n Alright!\n")
shared_data = dict(
    gameState = -1, #0-Idle -1 - Stop
    targetColor =  "magenta",
    gameLogicStart = False,
    wsStop = False,
    gameThreadUp = False,
    wsThreadUp = False,
    camThreadUp = False,
    name = "BTS"
)
o_ws = ws_client.wsConnectionClass(shared_data)
o_game = game.GameLogic(shared_data)
o_gui = gui.BTSControlPanel(shared_data,o_ws,o_game)
move.initSerial()
cam_thread = threading.Thread(target = o_game.infiniteCameraProcessing, args = ())
cam_thread.start()
threading.Thread(o_gui.startPanel()).start() # start tkinter gui fcn
#threading.Thread(o_game.infiniteCameraProcessing()).start()
