ut-robotics/picr21-team-bts/BTS dev/tkinter_threading_demo.py

#B_T_S Final Code#
#January 26th 2022#

# Run tkinter code in another thread

import tkinter as tk
import threading

class App(threading.Thread):

    def __init__(self):
        threading.Thread.__init__(self)
        self.start()

    def callback(self):
        self.root.quit()

    def run(self):
        self.root = tk.Tk()
        self.root.protocol("WM_DELETE_WINDOW", self.callback)

        label = tk.Label(self.root, text="Hello World")
        label.pack()

        self.root.mainloop()


app = App()
print('Now we can continue running code while mainloop runs!')

for i in range(100000):
    print(i)
