ut-robotics/picr21-team-bts/(commit log)

2021-09-26 Create B.T.S Robot Flowchart Version1.png
2021-10-14 Create basic.py
    Basic test routine commands /
    Robot motors previous state termination.
2021-11-04 Movement matrix add, CV to realsenes
    move to modules next
    [Movement_matrix.xlsx]
2021-11-08 Files for Mainboard Comms
    Sort out initial issues from 2 weeks ago and need these codes review
    [maneuver_inator.py, robit_manager_inator.py, serial_comms_inator.py]
2021-11-08 Rename Folder
    Rename folder Mainboard Communication to Deprecated_Codes since we started a new .py structure to address all the issues.
    [Movement_matrix.xlsx]
2021-11-08 Rename Folder
    This folder exists to help us consolidate development efforts before scripts are ready to be merged with main files, ready for review by mentors.
    [Movement_matrix.xlsx]
2021-11-16 Mainboard design files
    [PCB1.PcbDoc, PcbLib1.PcbLib, Schlib1.SchLib, Sheet1.SchDoc, picr21-team-BTS-mainboard.PrjPcb]
2021-12-15 Dev with web sockets, img processing & Kobi aim
    Kobi aim lags time by time, but has omni movement in aiming instead of mine common movement solution.
    Python is garbage. 1 000 000 op in array in python takes 1 sec, while in c 0.001 sec. Good joke. Library for convolution in python slows downs fps to 10, while own written C code imported in python drops fps to 20 with the same result. May get even better results using assembler.
    Anyway convolution results are not that good, while it is basic ways to find contures. TBD
2021-12-16 PCB Completion
    [PCB1.PcbDoc, PcbLib1.PcbLib, Schlib1.SchLib, Sheet1.SchDoc, picr21-team-BTS-mainboard.PrjPcb]
2021-12-17 PCB completed
    [PCB1.PcbDoc]
2021-12-27 Gerber and NC drill files generated
    [PCB1.GBL, PCB1.GBO, PCB1.GBP, PCB1.GBS, PCB1.GM1, PCB1.GTL, PCB1.GTO, PCB1.GTP]
2021-12-30 PCB Done
    [PCB1.PcbDoc]
2022-01-19 Refactor
    2(3) threads to 4(5) threads.
    ws fixes (terminate on server, dynamic command amount)
    image processing separeted from movement
    [game_logician_inator.py, rc_inator.py, robit_manager_inator.py, see_everything_inator.py, ws_client.py]
2022-01-19 border detection + game logic fix
    [game_logician_inator.py, image_processor.py, see_everything_inator.py, utils.c]
2022-01-23 Update game_logician_inator.py
    minor game logic fixes
    [game_logician_inator.py]
2022-01-24 PCB documentation added
2022-01-25 B_T_S Final Code
    Clean up folders & files.
    [Movement_matrix.xlsx]
